Solar-Gators/Sunrider-MCTelemetry-PCB/MC_Telem.step

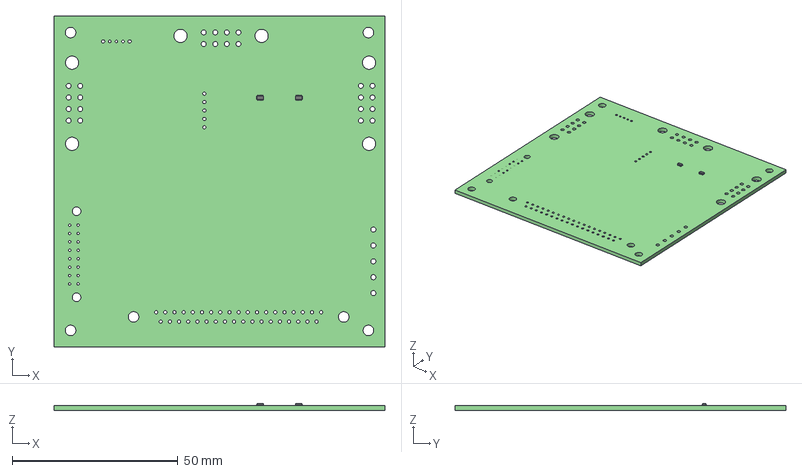
[picture p1: CAD file, 2023-09-11]
MC_Telem.step
100.0 x 100.0 x 2.25 mm
MC_Telem PCB
