Solar-Gators/Sunrider-MCTelemetry-PCB/MC_Telem.kicad_pcb

## KiCad design MC_Telem.kicad_pcb (2023-09-11)

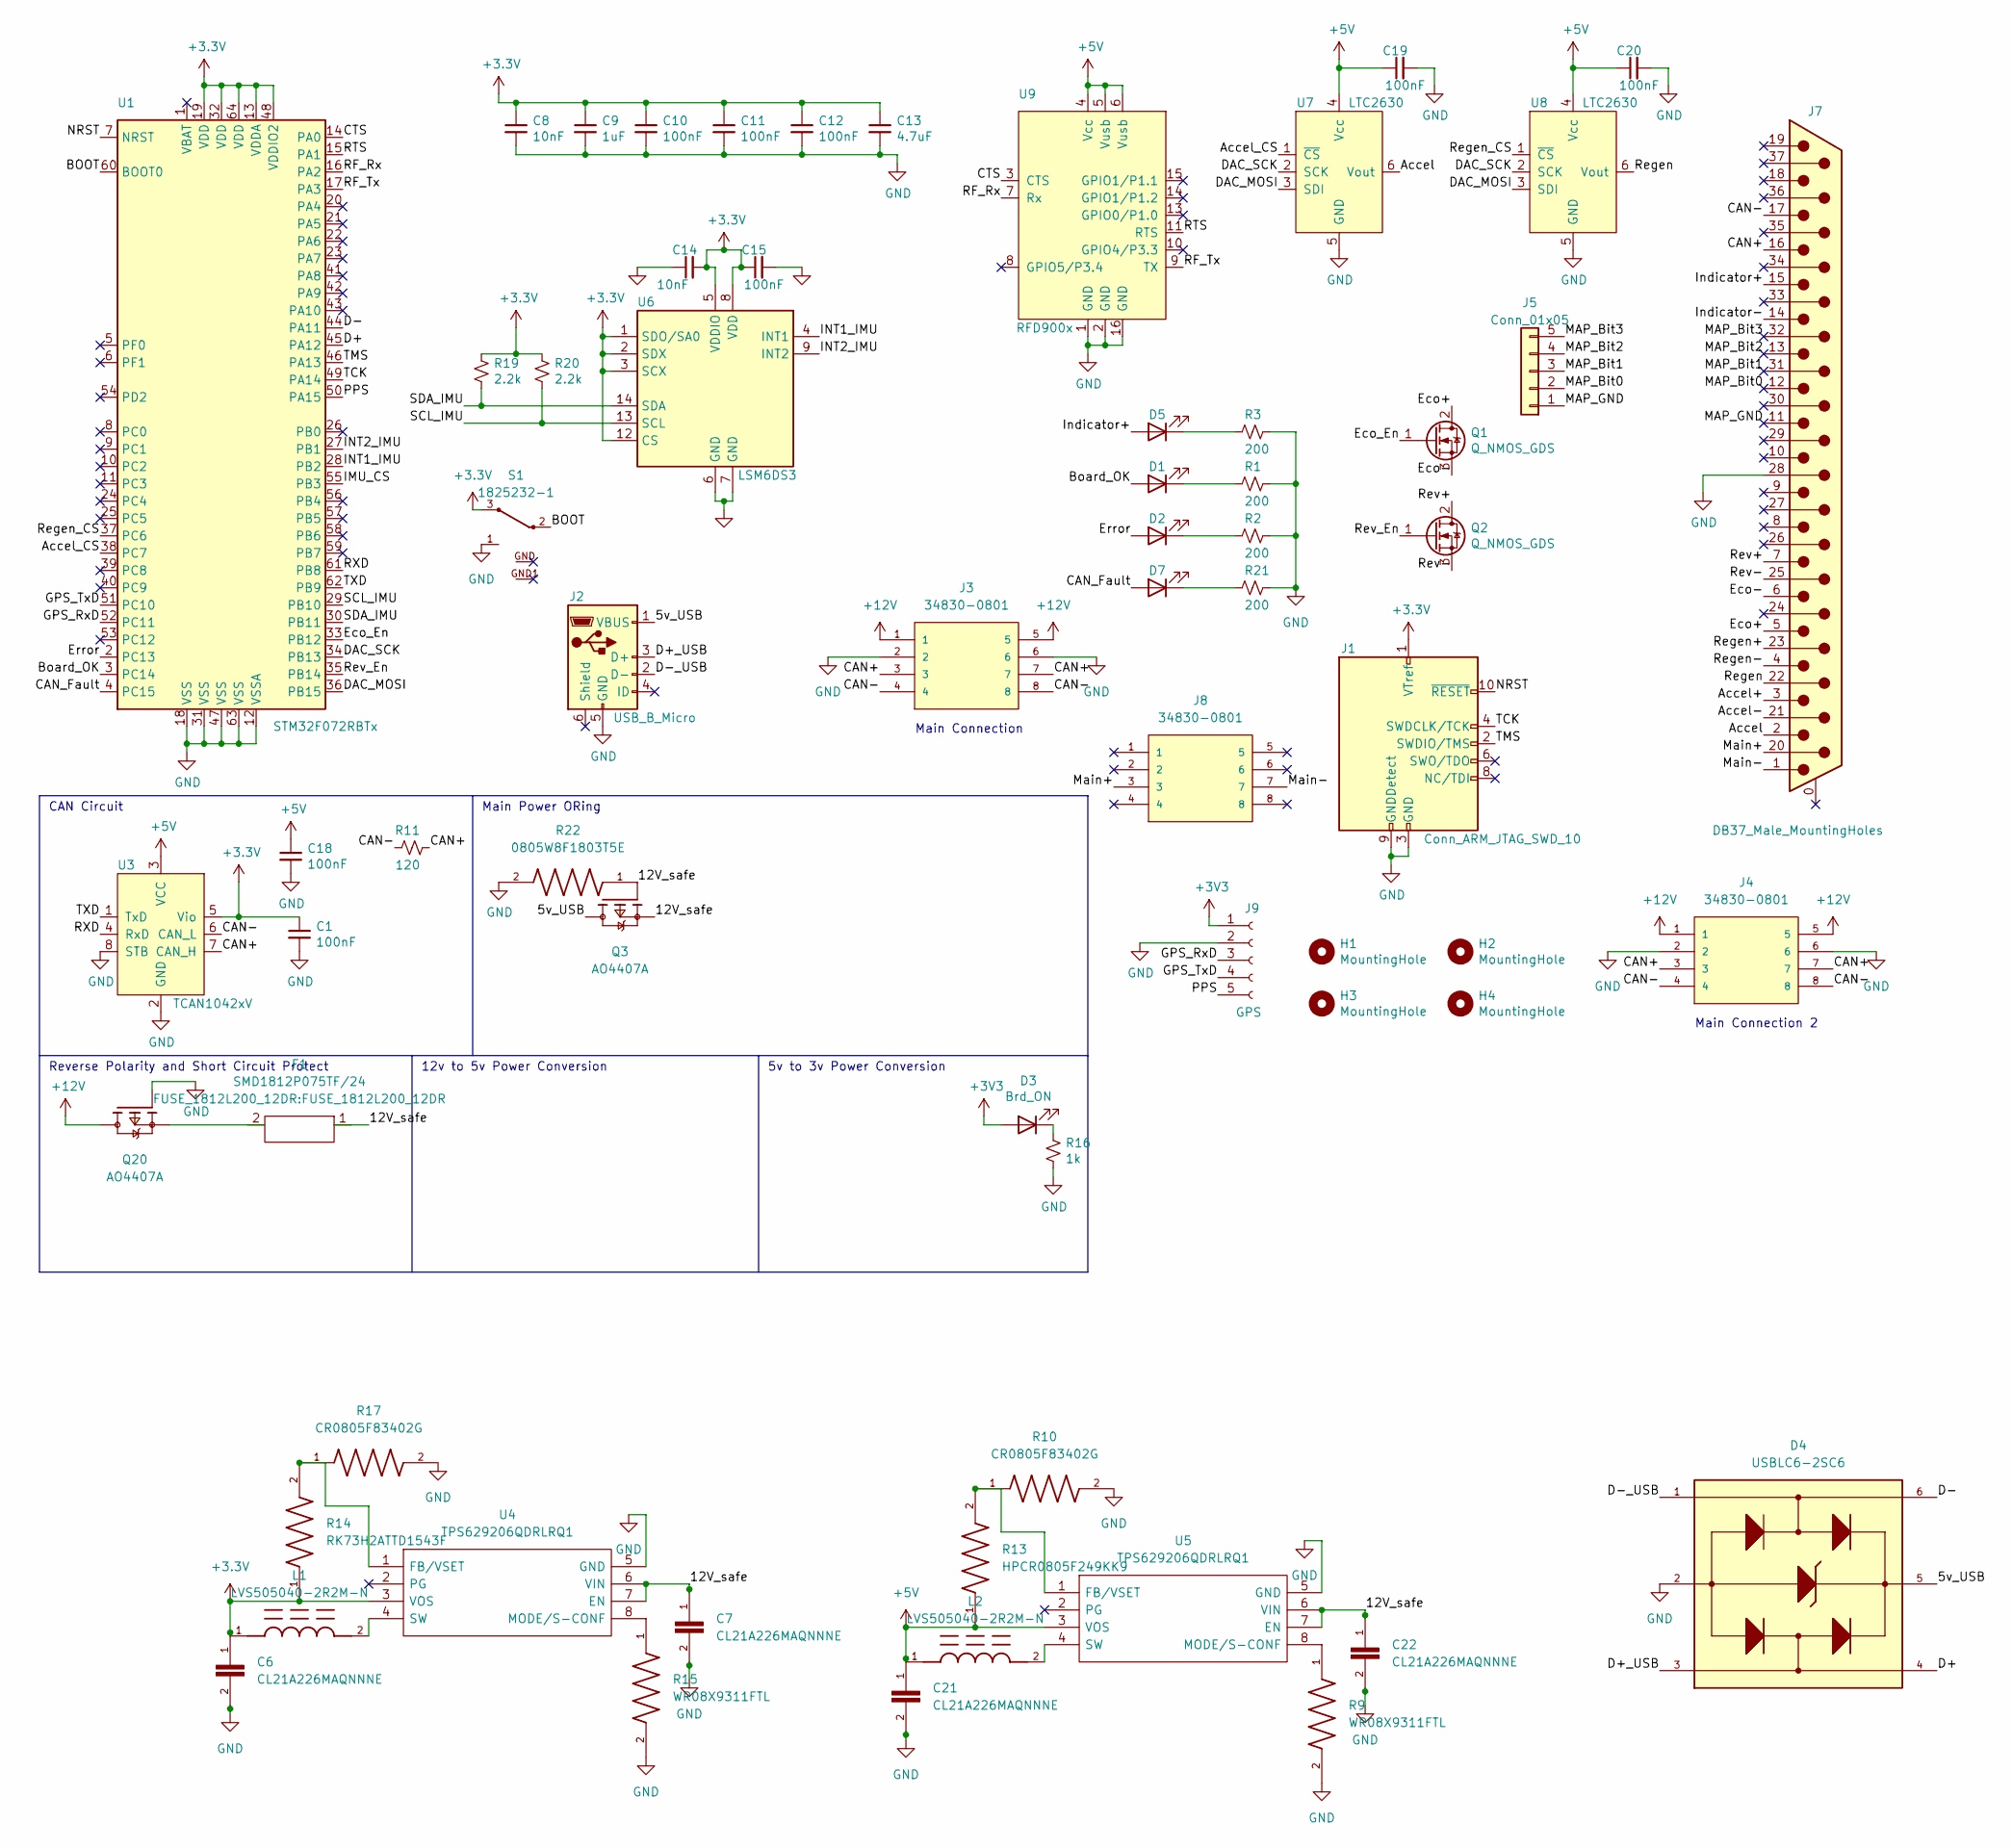
[picture p2: schematic MC_Telem.kicad_sch]

Parts:
C1, C10, C11, C12, C15, C18, C19, C20: 100nF; C_0402_1005Metric; LCSC# C307331
C6, C7, C21, C22: CL21A226MAQNNNE; CAPC2012X140N; JLCPCB C45783
C8, C14: 10nF; C_0402_1005Metric; LCSC# C15195
C9: 1uF; C_0402_1005Metric; LCSC# C52923
C13: 4.7uF; C_0402_1005Metric; LCSC# C23733
D1: Board OK; LED_0805_2012Metric; LCSC# C2297
D2: Error; LED_0603_1608Metric; LCSC# C2286
D3: Brd_ON; LED_0805_2012Metric; LCSC# C2297
D4: USBLC6-2SC6; SOT95P280X145-6N; JLCPCB C5180249
D5: Board OK; LED_0805_2012Metric; LCSC# C34499
D7: CAN ERR; LED_0603_1608Metric; LCSC# C2286
F1: SMD1812P075TF/24; FUSE_1812L200_12DR
H1, H2, H3, H4: MountingHole; MountingHole_3.2mm_M3
J1: Conn_ARM_JTAG_SWD_10; PinHeader_2x05_P1.27mm_Vertical_SMD
J2: USB_B_Micro; USB_Micro-B_Molex_47346-0001
J3, J4, J8: 34830-0801; MOLEX_34830-0801; PARTREV A2
J5: Conn_01x05; SolderWire-0.75sqmm_1x05_P4.8mm_D1.25mm_OD2.3mm
J7: DB37_Male_MountingHoles; DSUB-37_Male_Horizontal_P2.77x2.84mm_EdgePinOffset7.70mm_Ho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
J9: GPS; PinSocket_1x05_P2.54mm_Vertical
L1, L2: LVS505040-2R2M-N; IND_SDR0403-2R2ML
Q1, Q2: Q_NMOS_GDS; SOT-23; LCSC# C20917
Q3, Q20: AO4407A; SOIC127P600X175-8N; PARTREV I
R1, R2, R3, R21: 200; R_0603_1608Metric; LCSC# C8218
R9, R15: WR08X9311FTL; RESC2012X60N; JLCPCB C334950
R10, R17: CR0805F83402G; RESC2012X60N; JLCPCB C101673
R11: 120; R_1206_3216Metric_Pad1.30x1.75mm_HandSolder
R13: HPCR0805F249KK9; RESC2012X60N; JLCPCB C365271
R14: RK73H2ATTD1543F; RESC2012X60N; JLCPCB C317465
R16: 1k; R_0603_1608Metric; LCSC# C21190
R19, R20: 2.2k; R_0603_1608Metric; LCSC# C4190
R22: 0805W8F1803T5E; RESC2012X60N; JLCPCB C17501
S1: 1825232-1
U1: STM32F072RBTx; LQFP-64_10x10mm_P0.5mm
U3: TCAN1042xV; SOIC-8
U4, U5: TPS629206QDRLRQ1; SOTFL50P160X60-8N; Mouser Part Number 595-TPS629206QDRLRQ1
U6: LSM6DS3; LGA-14_3x2.5mm_P0.5mm_LayoutBorder3x4y; LCSC# C784817
U7, U8: LTC2630; SOT-363_SC-70-6_Handsoldering
U9: RFD900x

Connections:
+5V: C18.1, C19.1, C20.1, C21.1, L2.1, R13.1, U3.3 (VCC), U5.3 (VOS), U7.4 (Vcc), U8.4 (Vcc), U9.4 (Vcc), U9.5 (Vusb), U9.6 (Vusb)
+12V: J3.1, J3.5, J4.1, J4.5, Q20.5, Q20.6, Q20.7, Q20.8
/5v_USB: D4.5, J2.1 (VBUS), Q3.5, Q3.6, Q3.7, Q3.8
/12V_safe: C7.1, C22.1, F1.1, Q3.1, Q3.2, Q3.3, Q3.4, R22.1, U4.6 (VIN), U4.7 (EN), U5.6 (VIN), U5.7 (EN)
/Accel: J7.2, U7.6 (Vout)
/Accel+: J7.3
/Accel-: J7.21
/Accel_CS: U1.38 (PC7), U7.1 (~CS)
/BOOT: S1.2, U1.60 (BOOT0)
/Board_OK: D1.2 (A), U1.3 (PC14)
/CAN+: J3.3, J3.7, J4.3, J4.7, J7.16, R11.2, U3.7 (CAN_H)
/CAN-: J3.4, J3.8, J4.4, J4.8, J7.17, R11.1, U3.6 (CAN_L)
/CAN_Fault: D7.2 (A), U1.4 (PC15)
/CTS: U1.14 (PA0), U9.3 (CTS)
/D+: D4.4, U1.45 (PA12)
/D+_USB: D4.3, J2.3 (D+)
/D-: D4.6, U1.44 (PA11)
/D-_USB: D4.1, J2.2 (D-)
/DAC_MOSI: U1.36 (PB15), U7.3 (SDI), U8.3 (SDI)
/DAC_SCK: U1.34 (PB13), U7.2 (SCK), U8.2 (SCK)
/Eco+: J7.5, Q1.2 (D)
/Eco-: J7.6, Q1.3 (S)
/Eco_En: Q1.1 (G), U1.33 (PB12)
/Error: D2.2 (A), U1.2 (PC13)
/GPS_RxD: J9.3, U1.52 (PC11)
/GPS_TxD: J9.4, U1.51 (PC10)
/IMU_CS: U1.55 (PB3)
/INT1_IMU: U1.28 (PB2), U6.4 (INT1)
/INT2_IMU: U1.27 (PB1), U6.9 (INT2)
/Indicator+: D5.2 (A), J7.15
/Indicator-: J7.14
/MAP_Bit0: J5.2, J7.12
/MAP_Bit1: J5.3, J7.31
/MAP_Bit2: J5.4, J7.13
/MAP_Bit3: J5.5, J7.32
/MAP_GND: J5.1, J7.11
/Main+: J7.20, J8.3
/Main-: J7.1, J8.7
/NRST: J1.10 (~RESET), U1.7 (NRST)
/PPS: J9.5, U1.50 (PA15)
/RF_Rx: U1.16 (PA2), U9.7 (Rx)
/RF_Tx: U1.17 (PA3), U9.9 (TX)
/RTS: U1.15 (PA1), U9.11 (RTS)
/RXD: U1.61 (PB8), U3.4 (RxD)
/Regen: J7.22, U8.6 (Vout)
/Regen+: J7.23
/Regen-: J7.4
/Regen_CS: U1.37 (PC6), U8.1 (~CS)
/Rev+: J7.7, Q2.2 (D)
/Rev-: J7.25, Q2.3 (S)
/Rev_En: Q2.1 (G), U1.35 (PB14)
/SCL_IMU: R20.2, U1.29 (PB10), U6.13 (SCL)
/SDA_IMU: R19.2, U1.30 (PB11), U6.14 (SDA)
/TCK: J1.4 (SWDCLK/TCK), U1.49 (PA14)
/TMS: J1.2 (SWDIO/TMS), U1.46 (PA13)
/TXD: U1.62 (PB9), U3.1 (TxD)
GND: C1.2, C6.2, C7.2, C8.2, C9.2, C10.2, C11.2, C12.2, C13.2, C14.1, C15.2, C18.2, C19.2, C20.2, C21.2, C22.2, D4.2, J1.3 (GND), J1.5 (GND), J1.9 (GNDDetect), J2.5 (GND), J3.2, J3.6, J4.2, J4.6, J7.28, J9.2, Q20.4, R1.1, R2.1, R3.1, R9.2, R10.2, R15.2, R16.2, R17.2, R21.1, R22.2, S1.1, U1.12 (VSSA), U1.18 (VSS), U1.31 (VSS), U1.47 (VSS), U1.63 (VSS), U3.2 (GND), U3.8 (STB), U4.5 (GND), U5.5 (GND), U6.6 (GND), U6.7 (GND), U7.5 (GND), U8.5 (GND), U9.1 (GND), U9.2 (GND), U9.16 (GND)
unnamed: D1.1 (K), R1.2
unnamed: D2.1 (K), R2.2
unnamed: D3.1 (K), R16.1
unnamed: D5.1 (K), R3.2
unnamed: D7.1 (K), R21.2
unnamed: F1.2, Q20.1, Q20.2, Q20.3
unnamed: L1.2, U4.4 (SW)
unnamed: L2.2, U5.4 (SW)
unnamed: R9.1, U5.8 (MODE/S-CONF)
unnamed: R10.1, R13.2, U5.1 (FB/VSET)
unnamed: R14.2, R17.1, U4.1 (FB/VSET)
unnamed: R15.1, U4.8 (MODE/S-CONF)

Notes on the sheet:
Reverse Polarity and Short Circuit Protect
5v to 3v Power Conversion
Main Connection
CAN Circuit
Main Connection 2
Main Power ORing
12v to 5v Power Conversion

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
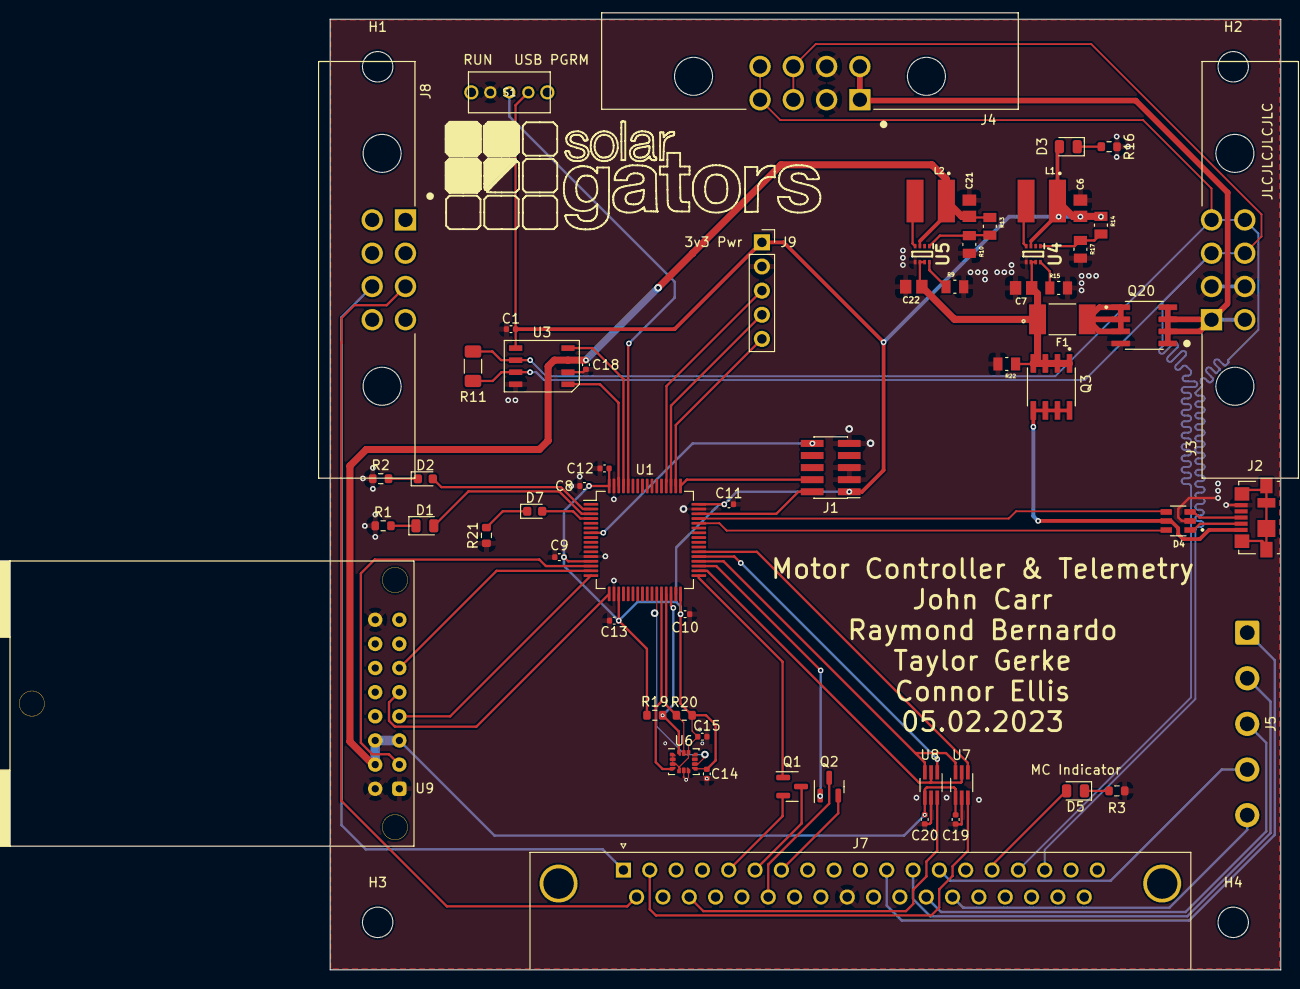
[picture p3: board MC_Telem.kicad_pcb from above]

Board: 2 copper layers, 100.0 x 100.0 mm, 65 parts (0 on the bottom side), 64 nets.
