Solar-Gators/Sunrider-MCTelemetry-PCB/(commit log)

2023-01-31 Initial Commit
    Known Issues
    5V LDO ADJ pin must be grounded
    5V power mux does not work and must be replaced
    [MC_Telem.kicad_pcb, MC_Telem.kicad_sch]
2023-09-11 FSGP MC Telemetry Hardware
    Final PCB revision used for Sunrider at FSGP 2023
    [MC_Telem-B_Cu.gbr, MC_Telem-B_Mask.gbr, MC_Telem-B_Paste.gbr, MC_Telem-B_Silkscreen.gbr, MC_Telem-Edge_Cuts.gbr, MC_Telem-F_Cu.gbr, MC_Telem-F_Mask.gbr, MC_Telem-F_Paste.gbr]
